MrDix/BKHD-FanController/firmware/Inc/ntc.h

/**
 * @file ntc.h
 * @brief NTC thermistor temperature measurement via ADC1.
 *
 * Reads the NTC1 voltage divider on PB7 (ADC1_IN11) and converts the ADC
 * sample to a temperature value using the Beta equation.
 *
 * Returns temperature in tenths of degrees Celsius (e.g. 523 = 52.3 C)
 * as a signed int16 so the value fits into the STS frame and can represent
 * under-temperature sensor failures with negative numbers.
 *
 * An invalid/absent sensor returns NTC_TEMP_INVALID.
 *
 * When the build-time option NTC1_ENABLED is 0, ntc_init() is a no-op and
 * ntc_read_tenths_celsius() always returns NTC_TEMP_INVALID. The ADC
 * peripheral and GPIO are left untouched so PB7 behaves exactly like on
 * a stock PCB without the NTC nachrüstung.
 */
#ifndef NTC_H
#define NTC_H

#include "main.h"
#include <stdint.h>

#define NTC_TEMP_INVALID  INT16_MIN

void    ntc_init(void);

/* One-shot ADC conversion. Call periodically (e.g. every STATUS_INTERVAL_MS).
 * Performs a short blocking poll with a bounded timeout (10 ms). At 12-bit
 * resolution with 160.5-cycle sampling the conversion finishes in well under
 * 1 ms, so the call almost always returns immediately and in the worst case
 * blocks for up to the timeout. */
int16_t ntc_read_tenths_celsius(void);

#endif /* NTC_H */
