MrDix/BKHD-FanController/(commit log)

2026-03-11 Initial commit: STM32G031 5-channel PWM fan controller
    Complete project with:
    - STM32G031K8T6 firmware (CMake + HAL): 5x 25kHz PWM, TACH RPM
    measurement, NMEA-style UART protocol, host watchdog, buzzer alarm
    - Linux host daemon (Python): hwmon temperature reading, configurable
    fan curves with hysteresis, systemd service
    - Documentation: UART protocol spec, hardware notes, full README
    [buzzer.c, buzzer.h, config.yaml, fan_control.c, fan_control.h, fan_controller.py, main.c, main.h]
2026-03-13 docs: add macOS/Windows build instructions and STLINK-V3MINIE flashing guide
    The README only covered Linux for building and flashing. This adds:
    - macOS prerequisites (Homebrew gcc-arm-embedded + cmake)
    - Windows prerequisites (Arm GNU Toolchain installer + CMake + Ninja/Make)
    - Windows Ninja build variant
    - STLINK-V3MINIE flashing setup for Linux, macOS, and Windows
    - Linux udev rules for non-root ST-Link access
    - Connection verification commands (st-info --probe, STM32_Programmer_CLI)
2026-03-13 docs: harden udev rule and clarify platform labels per review
    - Use GROUP="plugdev", MODE="0660", TAG+="uaccess" instead of MODE="0666"
    to avoid world-writable USB device access
    - Annotate verification commands with their platform availability
2026-03-13 docs: fix Windows toolchain install instructions
    The Arm GNU Toolchain offers .msi and .zip downloads, not an .exe
    installer, and the .msi has no "Add to PATH" checkbox. Updated to
    reflect the actual options and note that PATH must be set manually.
2026-03-13 docs: fix Arm GNU Toolchain install path on Windows
2026-03-13 docs: fix Windows build — require explicit CMake generator
    CMake defaults to NMake on Windows which fails without Visual Studio.
    Split build section into Linux/macOS and Windows, showing Ninja and
    MinGW Makefiles as generator options.
2026-03-13 fix: Windows build and flash support
    - arm-none-eabi.cmake: append .exe suffix on Windows so CMake finds
    the compiler
    - stm32g0xx_hal_conf.h: enable HAL_DMA_MODULE_ENABLED (required by
    TIM/UART headers in newer HAL) and add assert_param fallback macro
    - CMakeLists.txt: add DMA HAL source files
    - README: overhaul Windows flashing docs based on real-world testing:
    - stlink-tools do not support STLINK-V3 on Windows
    - recommend OpenOCD as primary Windows flash tool
    - note that STM32CubeProgrammer installer wizard may hide behind
    other windows
    - document that STLINK-V3MINIE does not supply target power
2026-03-13 docs: add flashing setup photo showing power supply and SWD connection
2026-03-13 docs: add production jumper configuration photo and description
    Shows the two jumpers required for installed operation:
    - Power jumper for GPIO header supply
    - SWD pin protection jumper to prevent shorts against NVMe heatsink
2026-03-13 fix: address CodeRabbit review findings
    - arm-none-eabi.cmake: use CMAKE_HOST_WIN32 instead of WIN32 (WIN32
    reflects target, not host, and is always false with Generic toolchain)
    - README: remove POSIX backslash line continuation from OpenOCD command
    for Windows cmd.exe/PowerShell compatibility
    - README: add "init; shutdown" to OpenOCD verify command so it exits
    instead of running as a blocking server
    - README: fix list numbering (4 -> 3) and clarify that MinGW Makefiles
    generator requires mingw32-make.exe, not generic make
2026-04-10 Support indexed sensor names in find_hwmon_by_name
    Allow 'name:N' syntax to select the Nth hwmon match (0-based), enabling
    disambiguation when multiple sensors share the same name (e.g. 'nvme:0',
    'nvme:1', 'spd5118:1'). Iteration order is stabilized via sorted().
    [fan_controller.py]
2026-04-10 docs: add BKHD-2049NP-6L-15 user manuals (EN + CN)
    Adds the original Chinese user manual (PDF) and the translated English
    version (PDF + DOCX source) for the BKHD-2049NP-6L-15 155H enclosure.
2026-04-18 feat(ntc): NTC1 thermistor input on PB7 + buzzer stuck-on fix (#2)
    * feat(ntc): add NTC1 thermistor input on PB7 (ADC1_IN11) and fix buzzer stuck-on bug
    Firmware changes:
    - Add ntc module: ADC1 single-conversion on PB7 (ADC1_IN11) for Semitec 104NT
    via Steinhart-Hart/Beta equation. 100k pullup from +3V3. Returns tenths of
    degrees Celsius (e.g. 523 = 52.3 C).
    - Extend STS frame with trailing temperature field t1 (tenths of C), signed
    int16 encoded as decimal. Host-side parse accepts both old (13-field) and
    new (14-field) frames for backward compatibility.
    - Fix buzzer stuck-on: when err_mask and failsafe both clear while
    buzzer_blink_update() left the GPIO in HIGH state, buzzer_off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
    [buzzer.c, config.yaml, fan_controller.py, main.c, main.h, ntc.c, ntc.h, uart_protocol.c]
2026-04-18 fix(hal): enable HAL_ADC_MODULE when NTC1_ENABLED=1 (#3)
    Building the firmware with -DNTC1_ENABLED=1 failed because
    stm32g0xx_hal_conf.h never set HAL_ADC_MODULE_ENABLED. Without that
    define, stm32g0xx_hal_adc.h is not included, so ADC_HandleTypeDef and
    every ADC_* macro used by Src/ntc.c and Src/stm32g0xx_hal_msp.c are
    undeclared, and the compiler falls back to unrelated "did you mean"
    suggestions from unrelated modules.
    Gate HAL_ADC_MODULE_ENABLED on NTC1_ENABLED so the stock build stays
    free of ADC HAL code, and add the ADC header include block. A local
    default of NTC1_ENABLED=0 keeps the header usable even outside the
    CMake build that supplies it on the command line.
    Regression from PR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
2026-04-19 docs(readme): warn about STLINK-V3 USB 3.x enumeration issue
    When plugged into a USB 3.x host port on Windows, the STLINK-V3MINIE can
    fail to enumerate cleanly with certain Intel / ASMedia controllers and the
    WinUSB driver stack. OpenOCD reports a generic "Error: open failed" with
    no VID/PID detected, and both st-info and STM32CubeProgrammer show
    matching USB errors on the same port. Moving the programmer to a USB 2.0
    port (or inserting a USB 2.0 hub) lets the exact same flash command
    succeed without any other change.
    Add a callout block right after the existing "does not supply power"
    warning so first-time flashers see the failure mode and the fix before
    they start debugging their wiring.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
